kareemaayman/balancing_robot/ESP32/SelfBalancingRobot/EncoderReader.h

#ifndef ENCODER_READER_H
#define ENCODER_READER_H

#include <Arduino.h>

class EncoderReader {
private:
    // Encoder pins
    const uint8_t pinA;
    const uint8_t pinB;
    
    // Specs
    const uint16_t PPR;           // Pulses per revolution from motor
    const uint16_t gearRatio;
    const uint16_t ticksPerRev;
    
    // Tracking
    volatile int64_t count;
    int64_t lastCount;
    int32_t lastDelta;
    
    // Speed
    unsigned long lastUpdateTime;
    double speedTicksPerSec;
    
    // ISR helper
    static EncoderReader* instances[4];  // Support up to 4 encoders
    static void isrA(void* arg);
    static void isrB(void* arg);
    void handleA();
    void handleB();
    
public:
    EncoderReader(uint8_t pinA, uint8_t pinB, 
                  uint16_t PPR = 20, uint16_t gearRatio = 30);
    
    void initialize();
    
    // Get current count
    int64_t getCount() const { return count; }
    int32_t getLastDelta() { return lastDelta; }
    
    // Update and get speed
    void updateSpeed();
    double getSpeedTicksPerSec() const { return speedTicksPerSec; }
    double getSpeedRPM() const;
    
    // Reset
    void reset();
    void resetSpeed();
    
    // Debug
    void printDebug();
};

#endif
