kareemaayman/balancing_robot/(commit log)

2025-11-23 removed LMotorController because we are using ESP32
2025-11-23 removed LMotorController include because we are using ESP32
2025-11-23 added a code that helps setting calibration values for imu
2025-11-26 fixing pwm
2025-11-28 imu calibration with esp32
2025-12-13 kalman filter
2025-12-19 fix imu
2025-12-26 Yaw control
